galactic-forensics/DigOutBox/hardware/README.md

# Hardware

These folders contain all files for building the hardware.
The subfolder `case` contains pdf files
and the original
[Inkscape](https://inkscape.org/)
file for laser cutting the case.

For assembly instructions,
please see the documentation on
[ReadTheDocs](https://digoutbox.readthedocs.io/).
