galactic-forensics/DigOutBox/firmware/README.md

# Firmware

This folder contains the firmware for the DigOutBox.
The following folders are available:

- `DigOutBox_fw_v*`: The current firmware for the DigOutBox.
- `configs`: Configuration files for existing boxes.
- `old`: Old firmware versions.

Please see the documentation on
[ReadTheDocs](https://digoutbox.readthedocs.io/)
for more information on how to use the firmware.
