galactic-forensics/DigOutBox/release_text.md

This is the first full release of the `controller`, `firmware`, and GUI (for Windows). Please consult the [documentation](https://digoutbox.readthedocs.io/) for more information on installation, setup, and usage.

*Changes from v0.1.0:*

- Added support for interlocking the DigOutBox using the `TRIG` line (deactivated by default in firmware)
- Added support for software lockout on the bottom left button of the remote
- Added OSHW certification
