galactic-forensics/DigOutBox/docs/images.md

# Images

### Transparent `llnl001` box

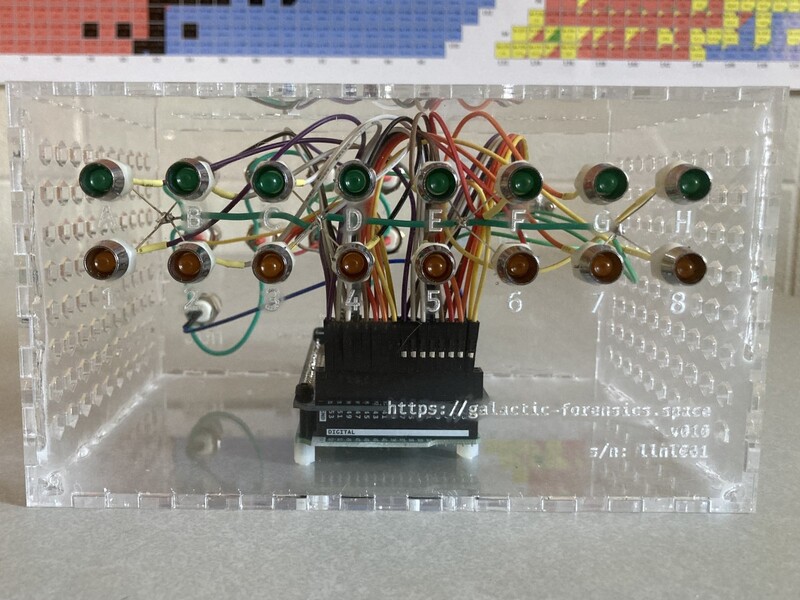
[picture p17: docs/img/boxes/llnl001_front_small.jpeg]
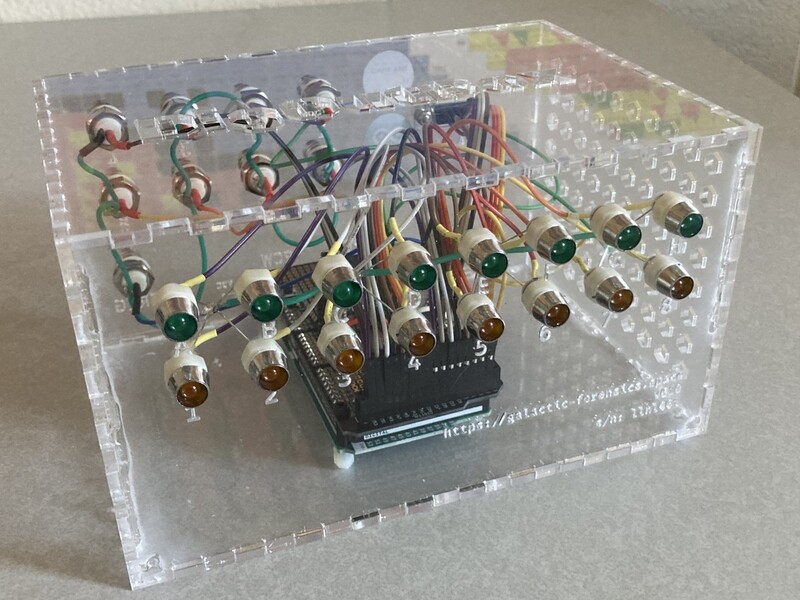
[picture p18: docs/img/boxes/llnl001_front_top_small.jpeg]
| [](img/boxes/llnl001_front.jpeg) | [](img/boxes/llnl001_front_top.jpeg) |
|:---:|:---:|
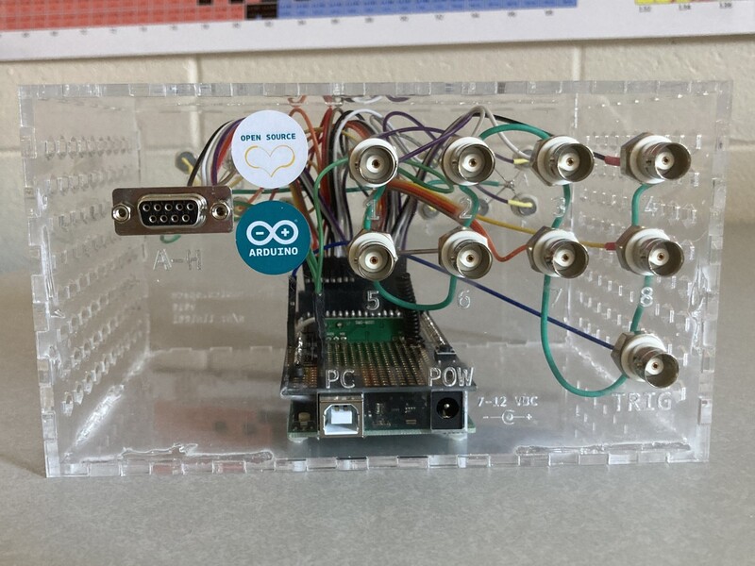
[picture p19: docs/img/boxes/llnl001_back_small.jpeg]
|  [](img/boxes/llnl001_back.jpeg)  | |

### The black/transparent `gfl002` box

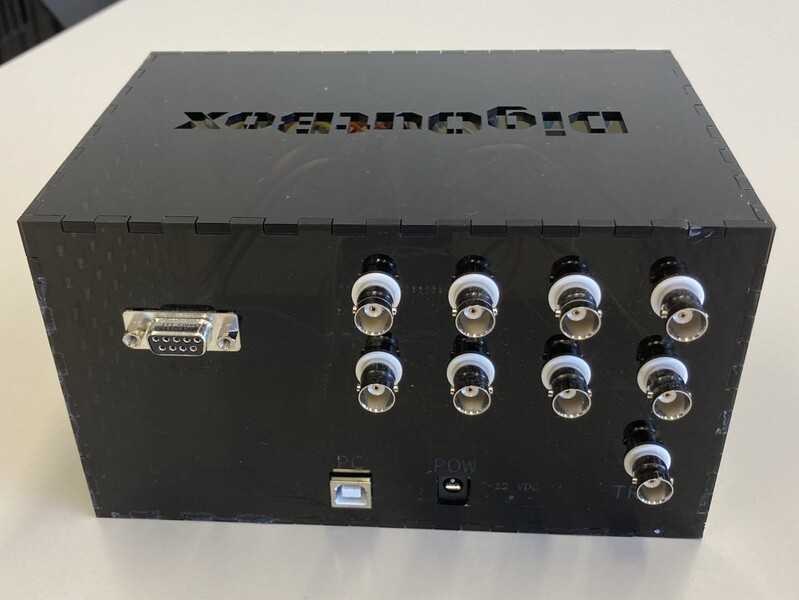
[picture p20: docs/img/boxes/gfl002_back_top_small.jpeg]
| [](img/boxes/gfl002_setup.jpeg) | [](img/boxes/gfl002_back_top.jpeg) |
|:---:|:---:|
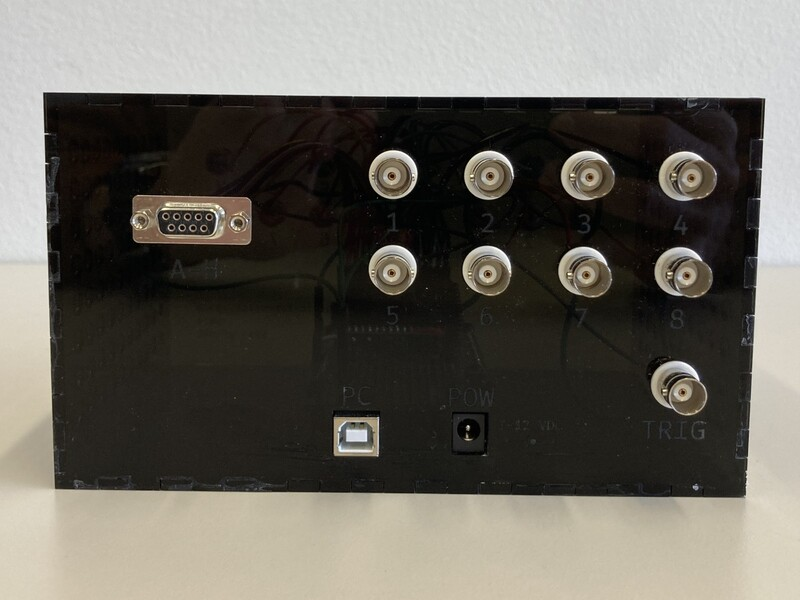
[picture p21: docs/img/boxes/gfl002_back_small.jpeg]
|  [](img/boxes/gfl002_back.jpeg)  | [](img/boxes/gfl002_inside.jpeg) |
