galactic-forensics/DigOutBox/docs/img/boxes/gfl002_back.jpeg

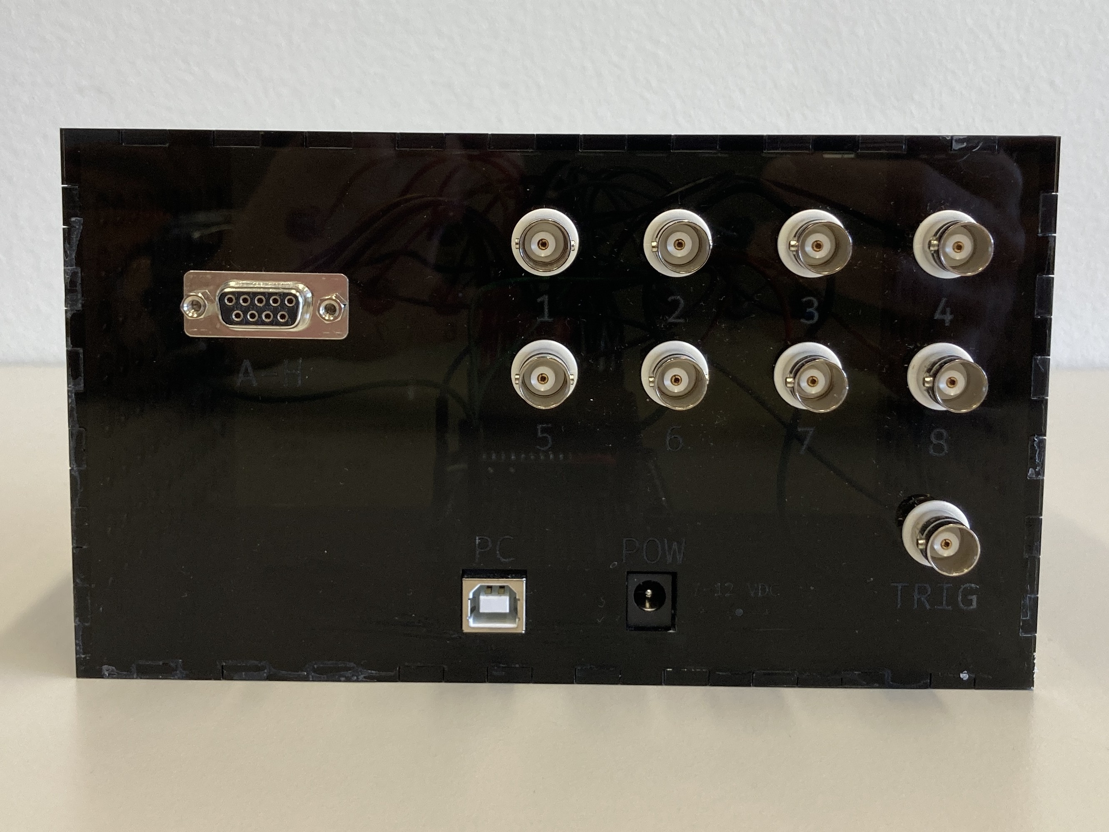
docs/img/boxes/gfl002_back.jpeg
