galactic-forensics/DigOutBox/docs/img/certification-mark-CH000020-wide.png

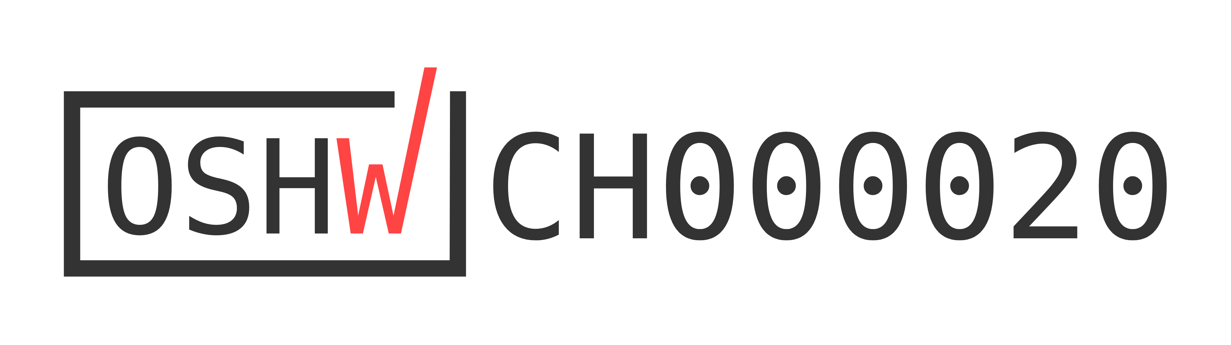
docs/img/certification-mark-CH000020-wide.png
