galactic-forensics/DigOutBox/hardware/v1/DigIOBox_10chan.FCStd

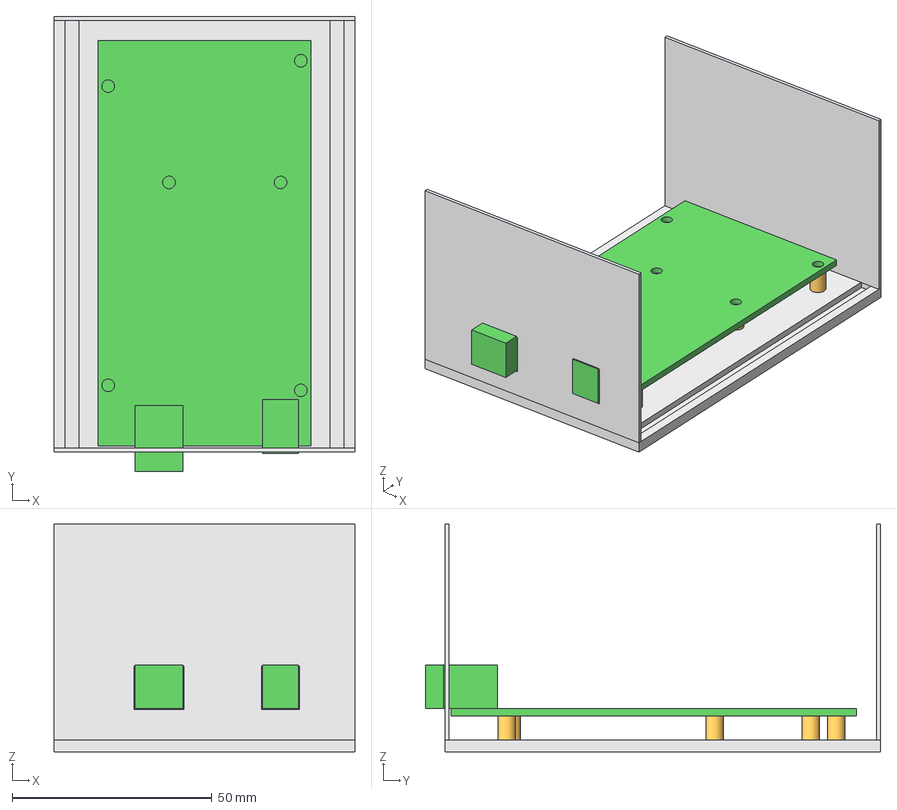
[picture p24: CAD file, 2022-03-16, last stored version]
hardware/v1/DigIOBox_10chan.FCStd
75.3 x 113.9 x 57.0 mm
usb_jack
dc_jack
arduino_board
front_panel
p006
p001
p002
p003
p004
p005
back_panel
base_plate
