galactic-forensics/DigOutBox/docs/changelog.md

# Changelog

## Version 0.2

- Safety features were added:
  - Interlock functionality
  - Software lockout capability when using remote
- Overall enhancements of tooltips in GUI

## Version 0.1

Initial release
