galactic-forensics/DigOutBox/(threads)

Thread 2 (2023-02-23):

Arduino restarts when opening the serial connection

trappitsch, 2023-02-23:
Every time the serial connection with the `controller_cli` is opened, the Arduino restarts and turns all outputs into the off state (as it should upon a restart). This is part of the Arduino, see here: https://github.com/pyserial/pyserial/issues/329#issuecomment-791997557
Setting `dsrdtr=True` in the connection seems not to change this behavior. However, Adding a 10uF capacitor between reset and ground solves the issue. However, this does not allow to upload firmware anymore.

Solution:
- Modify hardware to include 10uF capacitor between reset and ground
- Add a removable jumper: Removing this will allow flashing firmware

This will take care of the reset issue and allow establishing connections with the states remembered

trappitsch, 2023-02-27:
A fix was implemented and is now documented in the hardware and firmware READMEs.

Closed 2023-02-27.

Thread 32 (2024-01-11):

Documentation

trappitsch, 2024-01-11:
With the `controller_cli` and the `controller` GUI version, the documentation as it is handled now just via readme files in the respective folders is getting clunky.
I started creating a website in the `docs` folder (generated by sphinx and currently deployed as a github page). All readme documentation should be transported over there.

One issue with github pages is, that I'm unclear on how versioning will work. If it is important to keep old versions, the docs might have to switch over to readthedocs.

The main readme on the page should in the future:
- give details on the project
- explain what modules are available (hardware, firmware, cli, gui, ...) and link to the correct page in the docs
- explain how versioning works
- status badges

Closed 2024-01-21.
