galactic-forensics/DigOutBox/hardware/case/digout_box_laser_cutting_cut_layer.pdf

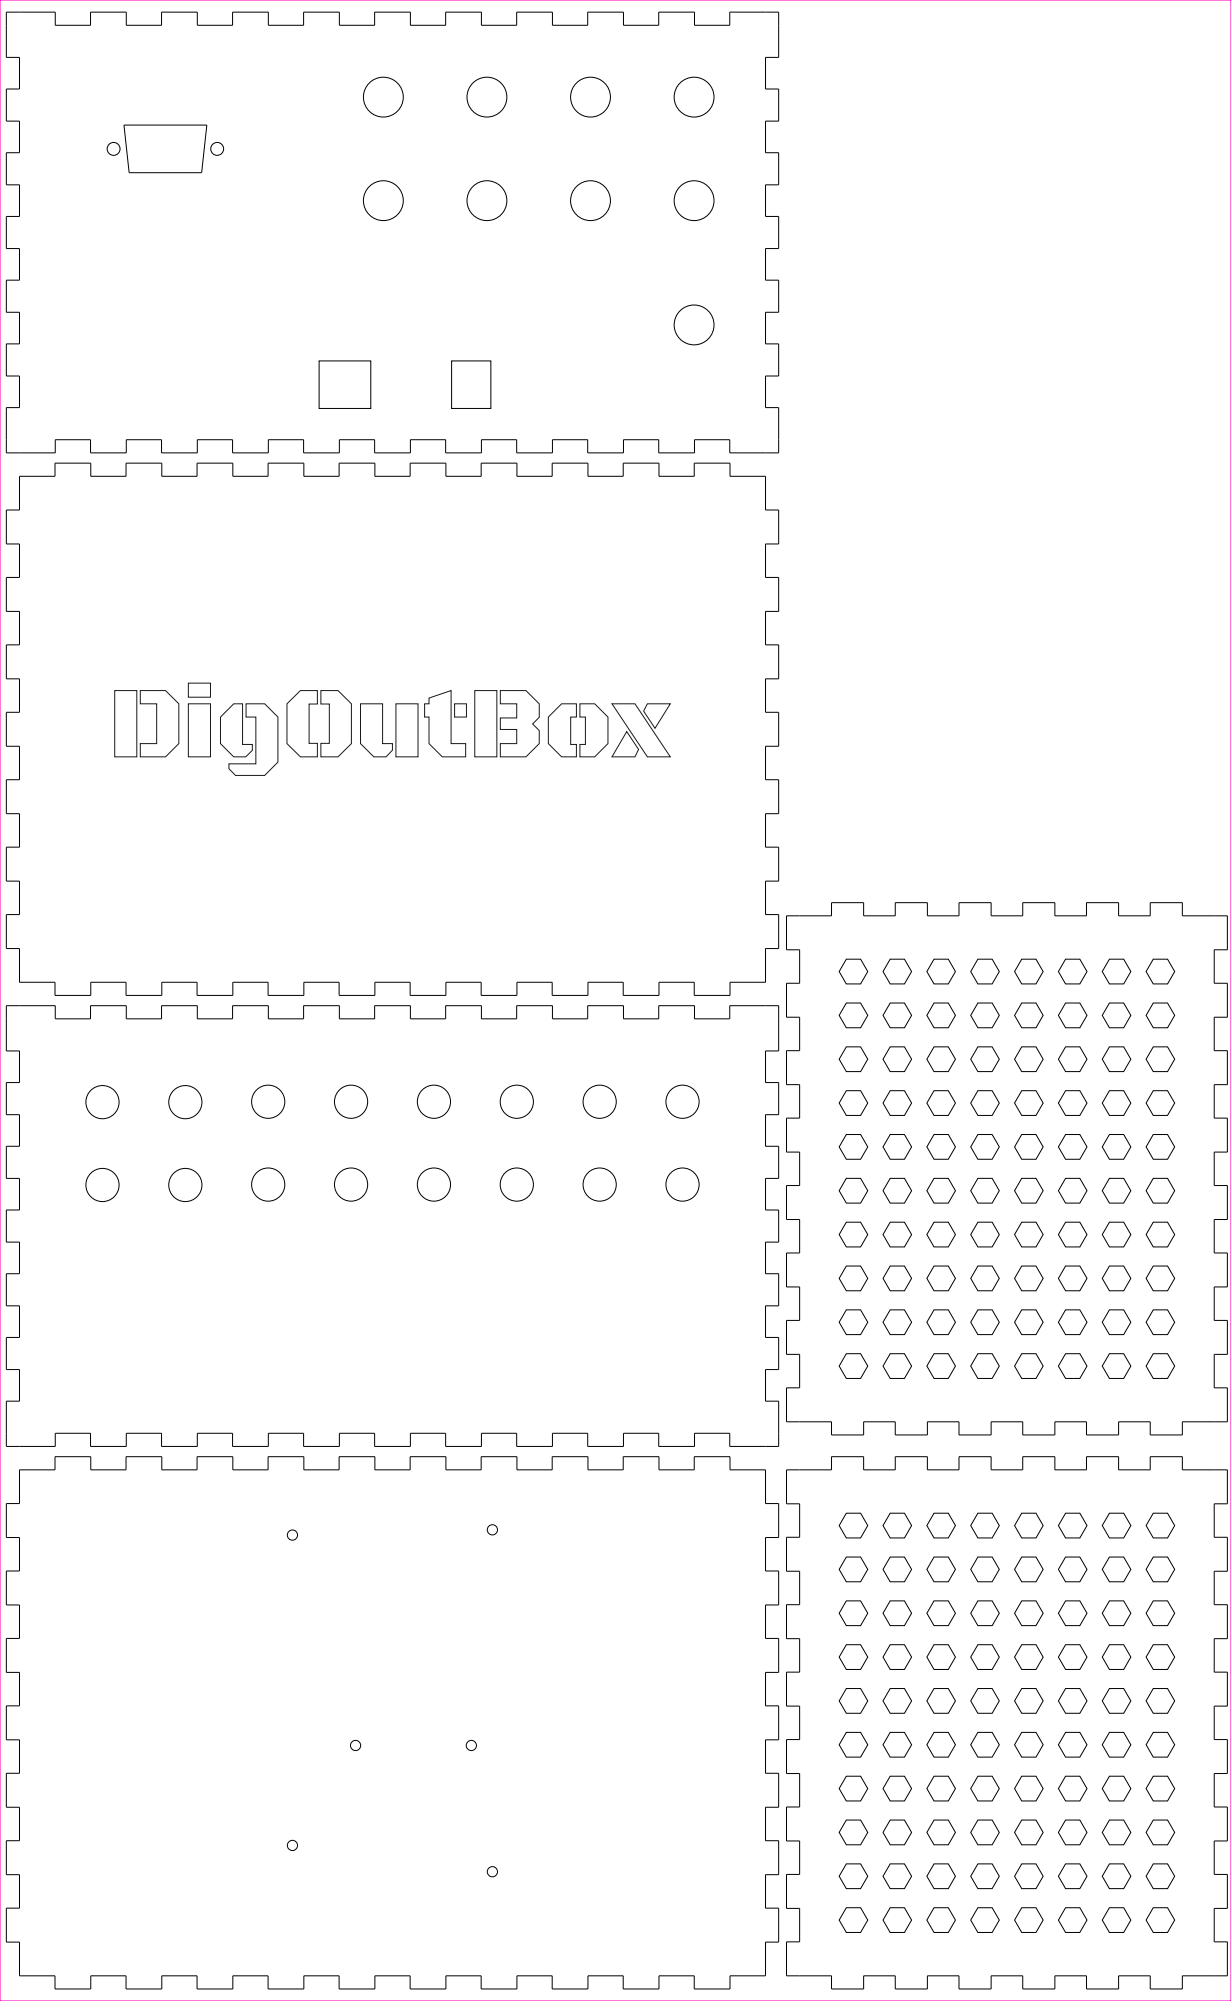
[picture p25: page 1]
