galactic-forensics/DigOutBox/(commit log)

2022-03-16 Start of 10 channel DigIOBox 3d print design
    [DigIOBox_10chan.FCStd]
2022-03-21 First version of firmware v010
    [DigIOBox_10chan.FCStd]
2022-03-28 Firmware mostly there, first config for llnl001
    [llnl001.xlsx]
2022-03-28 add second remote to llnl001
    [llnl001.xlsx]
2023-02-20 Extend readme, add hardware & firmware instructions
    [gfl002.xlsx, llnl001.xlsx]
2023-02-20 Remove case pictures from wrong folder
2023-02-20 Stage first package for comms via CLI
    Works, but completely untested
    [.bumpversion.cfg]
2023-02-22 add pre-commit, test pip install error
    [.bumpversion.cfg]
2023-02-23 Add controller_cli readme, slight comms modifications
    - also add a timeout to the serial communication
    - Add a `time.sleep(1)` 1 second delay after serial comms are established, since the Arduino will restart. see issue #2
    [device_comm.py, serial_comm.py]
2023-02-27 Add hardware modification to include jumper and capacitor to ground
2023-04-03 [pre-commit.ci] pre-commit autoupdate
    updates:
    - [github.com/psf/black: 23.1.0 → 23.3.0](https://github.com/psf/black/compare/23.1.0...23.3.0)
2023-05-01 [pre-commit.ci] pre-commit autoupdate
    - [github.com/asottile/pyupgrade: v3.3.1 → v3.3.2](https://github.com/asottile/pyupgrade/compare/v3.3.1...v3.3.2)
    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
2023-05-08 [pre-commit.ci] pre-commit autoupdate
    - [github.com/asottile/pyupgrade: v3.3.2 → v3.4.0](https://github.com/asottile/pyupgrade/compare/v3.3.2...v3.4.0)
    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
2023-06-12 [pre-commit.ci] pre-commit autoupdate
    - [github.com/asottile/pyupgrade: v3.4.0 → v3.6.0](https://github.com/asottile/pyupgrade/compare/v3.4.0...v3.6.0)
    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
2023-06-19 [pre-commit.ci] pre-commit autoupdate
    - [github.com/asottile/pyupgrade: v3.6.0 → v3.7.0](https://github.com/asottile/pyupgrade/compare/v3.6.0...v3.7.0)
    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
2023-07-03 [pre-commit.ci] pre-commit autoupdate
    - [github.com/asottile/pyupgrade: v3.7.0 → v3.8.0](https://github.com/asottile/pyupgrade/compare/v3.7.0...v3.8.0)
    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
2023-07-10 [pre-commit.ci] pre-commit autoupdate
    - [github.com/asottile/pyupgrade: v3.8.0 → v3.9.0](https://github.com/asottile/pyupgrade/compare/v3.8.0...v3.9.0)
    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
2023-07-18 [pre-commit.ci] pre-commit autoupdate
    - [github.com/psf/black: 23.3.0 → 23.7.0](https://github.com/psf/black/compare/23.3.0...23.7.0)
    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
2023-08-01 [pre-commit.ci] pre-commit autoupdate
    - [github.com/asottile/pyupgrade: v3.9.0 → v3.10.1](https://github.com/asottile/pyupgrade/compare/v3.9.0...v3.10.1)
    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
2023-09-12 [pre-commit.ci] pre-commit autoupdate
    - [github.com/psf/black: 23.7.0 → 23.9.1](https://github.com/psf/black/compare/23.7.0...23.9.1)
    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
2023-09-19 [pre-commit.ci] pre-commit autoupdate
    - [github.com/asottile/pyupgrade: v3.10.1 → v3.11.0](https://github.com/asottile/pyupgrade/compare/v3.10.1...v3.11.0)
    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
2023-09-26 [pre-commit.ci] pre-commit autoupdate
    - [github.com/asottile/pyupgrade: v3.11.0 → v3.13.0](https://github.com/asottile/pyupgrade/compare/v3.11.0...v3.13.0)
    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
2023-10-03 [pre-commit.ci] pre-commit autoupdate
    - [github.com/asottile/pyupgrade: v3.13.0 → v3.14.0](https://github.com/asottile/pyupgrade/compare/v3.13.0...v3.14.0)
    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
2023-10-09 [pre-commit.ci] pre-commit autoupdate
    - [github.com/pre-commit/pre-commit-hooks: v4.4.0 → v4.5.0](https://github.com/pre-commit/pre-commit-hooks/compare/v4.4.0...v4.5.0)
    - [github.com/asottile/pyupgrade: v3.14.0 → v3.15.0](https://github.com/asottile/pyupgrade/compare/v3.14.0...v3.15.0)
    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
2023-10-23 [pre-commit.ci] pre-commit autoupdate
    - [github.com/psf/black: 23.9.1 → 23.10.0](https://github.com/psf/black/compare/23.9.1...23.10.0)
    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
2023-10-30 [pre-commit.ci] pre-commit autoupdate
    - [github.com/psf/black: 23.10.0 → 23.10.1](https://github.com/psf/black/compare/23.10.0...23.10.1)
    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
2023-11-13 [pre-commit.ci] pre-commit autoupdate
    - [github.com/psf/black: 23.10.1 → 23.11.0](https://github.com/psf/black/compare/23.10.1...23.11.0)
    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
2023-12-05 Added first steps for GUI, Channel setup A setup widget for the channel is provided. Note that the main widget is currently not connected to anything and is only a blank window.
    The channel configuration window can be started from within itself (`if __name__ == "__main__"`...)
2023-12-07 Added communication class (dummy mostly)
    - needs port checking and communications -> saved in settings
    - read all not implemented yet
    - many issues, but some simple things work for now :)
    [device_comm.py, serial_comm.py]
2023-12-08 Add settings, read, and automatic read with a timer
2024-01-03 remove some prints, set version to 0.1.0 in fbs
2024-01-08 [pre-commit.ci] pre-commit autoupdate
    - [github.com/psf/black: 23.11.0 → 23.12.1](https://github.com/psf/black/compare/23.11.0...23.12.1)
    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
2024-01-11 Update config files and docs
    [gfl002_fw_v010.xlsx, gfl002_fw_v020.xlsx, llnl001_fw_v010.xlsx, llnl001_fw_v020.xlsx]
2024-01-11 Add interlock state to GUI gray out buttons and to CLI
2024-01-20 Migrate dev process to rye (#37)
    Migrate the environment and whole testing workflow to rye. Much easier and cleaner to manage.
    * Migrate to rye
    migrate to rye, set up workspaces, add controller_cli (controller not yet)
    * add tomllib to actions workflow
    * change python version checkout
    * try excitedleigh setup-nox action
    * move all testing to rye
    - implement tests with rye
    - setup github action to use rye for all tests and lint
    * fix matrix version in rye setup
    * fix check mode workflow
    * finish workflow files (hopefully)
    * manage gui with rye
    * lint, add ruff pre-commit hook
    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
    [device_comm.py, serial_comm.py, util_fns.py]
2024-02-09 switch rye workflow for windows
2024-02-09 Switch to python installation
    Rye on windows has no working workflow, so we have to install things manually for now and then run fbs in the correct folder
2024-02-12 [pre-commit.ci] pre-commit autoupdate
    - [github.com/astral-sh/ruff-pre-commit: v0.2.0 → v0.2.1](https://github.com/astral-sh/ruff-pre-commit/compare/v0.2.0...v0.2.1)
    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
2024-02-19 [pre-commit.ci] pre-commit autoupdate
    - [github.com/astral-sh/ruff-pre-commit: v0.2.1 → v0.2.2](https://github.com/astral-sh/ruff-pre-commit/compare/v0.2.1...v0.2.2)
    - [github.com/asottile/pyupgrade: v3.15.0 → v3.15.1](https://github.com/asottile/pyupgrade/compare/v3.15.0...v3.15.1)
    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
2024-03-12 [pre-commit.ci] pre-commit autoupdate
    - [github.com/astral-sh/ruff-pre-commit: v0.2.2 → v0.3.2](https://github.com/astral-sh/ruff-pre-commit/compare/v0.2.2...v0.3.2)
    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
2024-03-12 [pre-commit.ci] auto fixes from pre-commit.com hooks
    for more information, see https://pre-commit.ci
    [util_fns.py]
2024-03-18 [pre-commit.ci] pre-commit autoupdate
    - [github.com/astral-sh/ruff-pre-commit: v0.3.2 → v0.3.3](https://github.com/astral-sh/ruff-pre-commit/compare/v0.3.2...v0.3.3)
    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
2024-03-25 [pre-commit.ci] pre-commit autoupdate
    - [github.com/astral-sh/ruff-pre-commit: v0.3.3 → v0.3.4](https://github.com/astral-sh/ruff-pre-commit/compare/v0.3.3...v0.3.4)
    - [github.com/asottile/pyupgrade: v3.15.1 → v3.15.2](https://github.com/asottile/pyupgrade/compare/v3.15.1...v3.15.2)
    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
2024-04-01 [pre-commit.ci] pre-commit autoupdate
    - [github.com/astral-sh/ruff-pre-commit: v0.3.4 → v0.3.5](https://github.com/astral-sh/ruff-pre-commit/compare/v0.3.4...v0.3.5)
    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
2024-04-08 [pre-commit.ci] pre-commit autoupdate
    - [github.com/pre-commit/pre-commit-hooks: v4.5.0 → v4.6.0](https://github.com/pre-commit/pre-commit-hooks/compare/v4.5.0...v4.6.0)
    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
2024-04-15 [pre-commit.ci] pre-commit autoupdate
    - [github.com/astral-sh/ruff-pre-commit: v0.3.5 → v0.3.7](https://github.com/astral-sh/ruff-pre-commit/compare/v0.3.5...v0.3.7)
    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
2024-04-22 [pre-commit.ci] pre-commit autoupdate
    - [github.com/astral-sh/ruff-pre-commit: v0.3.7 → v0.4.1](https://github.com/astral-sh/ruff-pre-commit/compare/v0.3.7...v0.4.1)
    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
2024-04-29 [pre-commit.ci] pre-commit autoupdate
    - [github.com/astral-sh/ruff-pre-commit: v0.4.1 → v0.4.2](https://github.com/astral-sh/ruff-pre-commit/compare/v0.4.1...v0.4.2)
    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
2024-05-06 [pre-commit.ci] pre-commit autoupdate
    - [github.com/astral-sh/ruff-pre-commit: v0.4.2 → v0.4.3](https://github.com/astral-sh/ruff-pre-commit/compare/v0.4.2...v0.4.3)
    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
2024-05-13 [pre-commit.ci] pre-commit autoupdate
    - [github.com/astral-sh/ruff-pre-commit: v0.4.3 → v0.4.4](https://github.com/astral-sh/ruff-pre-commit/compare/v0.4.3...v0.4.4)
    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
2024-05-27 [pre-commit.ci] pre-commit autoupdate
    - [github.com/astral-sh/ruff-pre-commit: v0.4.4 → v0.4.5](https://github.com/astral-sh/ruff-pre-commit/compare/v0.4.4...v0.4.5)
    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
2024-06-03 [pre-commit.ci] pre-commit autoupdate
    - [github.com/astral-sh/ruff-pre-commit: v0.4.5 → v0.4.7](https://github.com/astral-sh/ruff-pre-commit/compare/v0.4.5...v0.4.7)
    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
2024-06-10 [pre-commit.ci] pre-commit autoupdate
    - [github.com/astral-sh/ruff-pre-commit: v0.4.7 → v0.4.8](https://github.com/astral-sh/ruff-pre-commit/compare/v0.4.7...v0.4.8)
    - [github.com/asottile/pyupgrade: v3.15.2 → v3.16.0](https://github.com/asottile/pyupgrade/compare/v3.15.2...v3.16.0)
    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
2024-06-17 [pre-commit.ci] pre-commit autoupdate
    - [github.com/astral-sh/ruff-pre-commit: v0.4.8 → v0.4.9](https://github.com/astral-sh/ruff-pre-commit/compare/v0.4.8...v0.4.9)
    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
2024-06-24 [pre-commit.ci] pre-commit autoupdate
    - [github.com/astral-sh/ruff-pre-commit: v0.4.9 → v0.4.10](https://github.com/astral-sh/ruff-pre-commit/compare/v0.4.9...v0.4.10)
    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
2024-07-01 [pre-commit.ci] pre-commit autoupdate
    - [github.com/astral-sh/ruff-pre-commit: v0.4.10 → v0.5.0](https://github.com/astral-sh/ruff-pre-commit/compare/v0.4.10...v0.5.0)
    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
2024-07-08 [pre-commit.ci] pre-commit autoupdate
    - [github.com/astral-sh/ruff-pre-commit: v0.5.0 → v0.5.1](https://github.com/astral-sh/ruff-pre-commit/compare/v0.5.0...v0.5.1)
    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
2024-07-15 [pre-commit.ci] pre-commit autoupdate
    - [github.com/astral-sh/ruff-pre-commit: v0.5.1 → v0.5.2](https://github.com/astral-sh/ruff-pre-commit/compare/v0.5.1...v0.5.2)
    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
2024-07-22 [pre-commit.ci] pre-commit autoupdate
    - [github.com/astral-sh/ruff-pre-commit: v0.5.2 → v0.5.4](https://github.com/astral-sh/ruff-pre-commit/compare/v0.5.2...v0.5.4)
    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
2024-07-29 [pre-commit.ci] pre-commit autoupdate
    - [github.com/astral-sh/ruff-pre-commit: v0.5.4 → v0.5.5](https://github.com/astral-sh/ruff-pre-commit/compare/v0.5.4...v0.5.5)
    - [github.com/asottile/pyupgrade: v3.16.0 → v3.17.0](https://github.com/asottile/pyupgrade/compare/v3.16.0...v3.17.0)
    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
2024-08-05 [pre-commit.ci] pre-commit autoupdate
    - [github.com/astral-sh/ruff-pre-commit: v0.5.5 → v0.5.6](https://github.com/astral-sh/ruff-pre-commit/compare/v0.5.5...v0.5.6)
    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
2024-08-12 [pre-commit.ci] pre-commit autoupdate
    - [github.com/astral-sh/ruff-pre-commit: v0.5.6 → v0.5.7](https://github.com/astral-sh/ruff-pre-commit/compare/v0.5.6...v0.5.7)
    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
2024-08-19 [pre-commit.ci] pre-commit autoupdate
    - [github.com/astral-sh/ruff-pre-commit: v0.5.7 → v0.6.1](https://github.com/astral-sh/ruff-pre-commit/compare/v0.5.7...v0.6.1)
    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
2024-08-26 [pre-commit.ci] pre-commit autoupdate
    - [github.com/astral-sh/ruff-pre-commit: v0.6.1 → v0.6.2](https://github.com/astral-sh/ruff-pre-commit/compare/v0.6.1...v0.6.2)
    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
2024-09-09 [pre-commit.ci] pre-commit autoupdate
    - [github.com/astral-sh/ruff-pre-commit: v0.6.2 → v0.6.4](https://github.com/astral-sh/ruff-pre-commit/compare/v0.6.2...v0.6.4)
    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
2024-09-16 [pre-commit.ci] pre-commit autoupdate
    - [github.com/astral-sh/ruff-pre-commit: v0.6.4 → v0.6.5](https://github.com/astral-sh/ruff-pre-commit/compare/v0.6.4...v0.6.5)
    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
2024-09-23 [pre-commit.ci] pre-commit autoupdate
    - [github.com/astral-sh/ruff-pre-commit: v0.6.5 → v0.6.7](https://github.com/astral-sh/ruff-pre-commit/compare/v0.6.5...v0.6.7)
    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
2024-09-30 [pre-commit.ci] pre-commit autoupdate
    - [github.com/astral-sh/ruff-pre-commit: v0.6.7 → v0.6.8](https://github.com/astral-sh/ruff-pre-commit/compare/v0.6.7...v0.6.8)
    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
2024-10-07 [pre-commit.ci] pre-commit autoupdate
    - [github.com/pre-commit/pre-commit-hooks: v4.6.0 → v5.0.0](https://github.com/pre-commit/pre-commit-hooks/compare/v4.6.0...v5.0.0)
    - [github.com/astral-sh/ruff-pre-commit: v0.6.8 → v0.6.9](https://github.com/astral-sh/ruff-pre-commit/compare/v0.6.8...v0.6.9)
    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
2024-10-14 [pre-commit.ci] pre-commit autoupdate
    - [github.com/asottile/pyupgrade: v3.17.0 → v3.18.0](https://github.com/asottile/pyupgrade/compare/v3.17.0...v3.18.0)
    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
2024-10-21 [pre-commit.ci] pre-commit autoupdate
    - [github.com/astral-sh/ruff-pre-commit: v0.6.9 → v0.7.0](https://github.com/astral-sh/ruff-pre-commit/compare/v0.6.9...v0.7.0)
    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
2024-10-28 [pre-commit.ci] pre-commit autoupdate
    - [github.com/astral-sh/ruff-pre-commit: v0.7.0 → v0.7.1](https://github.com/astral-sh/ruff-pre-commit/compare/v0.7.0...v0.7.1)
    - [github.com/asottile/pyupgrade: v3.18.0 → v3.19.0](https://github.com/asottile/pyupgrade/compare/v3.18.0...v3.19.0)
    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
2024-11-04 [pre-commit.ci] pre-commit autoupdate (#82)
    - [github.com/astral-sh/ruff-pre-commit: v0.7.1 → v0.7.2](https://github.com/astral-sh/ruff-pre-commit/compare/v0.7.1...v0.7.2)
    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
2024-12-16 [pre-commit.ci] pre-commit autoupdate (#88)
    - [github.com/astral-sh/ruff-pre-commit: v0.8.2 → v0.8.3](https://github.com/astral-sh/ruff-pre-commit/compare/v0.8.2...v0.8.3)
    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
2025-01-21 [pre-commit.ci] pre-commit autoupdate (#91)
    * [pre-commit.ci] pre-commit autoupdate
    - [github.com/astral-sh/ruff-pre-commit: v0.8.6 → v0.9.2](https://github.com/astral-sh/ruff-pre-commit/compare/v0.8.6...v0.9.2)
    * [pre-commit.ci] auto fixes from pre-commit.com hooks
    * format with ruff
    ---------
    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
    [util_fns.py]
2025-02-24 [pre-commit.ci] pre-commit autoupdate (#95)
    - [github.com/astral-sh/ruff-pre-commit: v0.9.6 → v0.9.7](https://github.com/astral-sh/ruff-pre-commit/compare/v0.9.6...v0.9.7)
    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
2025-04-29 [pre-commit.ci] pre-commit autoupdate (#103)
    - [github.com/astral-sh/ruff-pre-commit: v0.11.6 → v0.11.7](https://github.com/astral-sh/ruff-pre-commit/compare/v0.11.6...v0.11.7)
    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
2025-05-26 [pre-commit.ci] pre-commit autoupdate (#107)
    - [github.com/astral-sh/ruff-pre-commit: v0.11.10 → v0.11.11](https://github.com/astral-sh/ruff-pre-commit/compare/v0.11.10...v0.11.11)
    - [github.com/asottile/pyupgrade: v3.19.1 → v3.20.0](https://github.com/asottile/pyupgrade/compare/v3.19.1...v3.20.0)
    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
2025-07-21 [pre-commit.ci] pre-commit autoupdate (#114)
    - [github.com/astral-sh/ruff-pre-commit: v0.12.3 → v0.12.4](https://github.com/astral-sh/ruff-pre-commit/compare/v0.12.3...v0.12.4)
    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
2025-08-18 [pre-commit.ci] pre-commit autoupdate (#118)
    - [github.com/astral-sh/ruff-pre-commit: v0.12.8 → v0.12.9](https://github.com/astral-sh/ruff-pre-commit/compare/v0.12.8...v0.12.9)
    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
2025-09-01 [pre-commit.ci] pre-commit autoupdate (#120)
    - [github.com/astral-sh/ruff-pre-commit: v0.12.10 → v0.12.11](https://github.com/astral-sh/ruff-pre-commit/compare/v0.12.10...v0.12.11)
    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
2025-09-08 [pre-commit.ci] pre-commit autoupdate (#121)
    - [github.com/astral-sh/ruff-pre-commit: v0.12.11 → v0.12.12](https://github.com/astral-sh/ruff-pre-commit/compare/v0.12.11...v0.12.12)
    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
2025-11-03 [pre-commit.ci] pre-commit autoupdate (#129)
    - [github.com/astral-sh/ruff-pre-commit: v0.14.2 → v0.14.3](https://github.com/astral-sh/ruff-pre-commit/compare/v0.14.2...v0.14.3)
    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
