galactic-forensics/DigOutBox/(notices)

Notices in the files:
README.md:
License: MIT
